R3PB/AIR-TRANSPONDER/Transmitter_AIR/README.md

# Oregon_NR

Данная библиотека Ардуино сделана на основе беспроводного протокола Oregon Scientific v2.1 и v3.0.
 
Последнее обновление 17.03.2021

Формат датчиков AAA Transmitter_AIR V1.2.

Кодирование GPS даннных и передача по радиоканалу на базовую станцию.
 
Так же поддерживается формат следующих датчиков(пока не исключены из поддержки)
// Приём и передача:
// THGN132N (THGR122N, THGN123N),
// RTGN318,
// THGR810.
// Тольок приём:
// THN132N,
// WGR800,	
// UVN800.
//
/////////////////////////////////////////////////////////////////////////////////////////////////////////////////////////////////////////////////

Код приёмника протестирован вовремя полётов планеров Бланик L13, на расстоянии от базовой станции 8 км и высотой полёта 1200 метров, 
при излучаемой мощности 100 милливатт на частоне 144.810 MHz
Для успешного приёма базовой станцией сигнала необходимо соблюдать следующие условия при передаче данных:
Приёмник FM
