R3PB/AIR-TRANSPONDER/Transmitter_AIR/PCB_files/README.MD

Здесь ссылка на разведённые печатные платы и схемы проекта. 
Там же в онлайнредакторе EasyEDA можно отредактировать, или свою улучшенную версию печатных плат.

Project homepage link：	https://oshwlab.com/tech_1596/AIR_TRANSPONDER
Open in editor：		https://easyeda.com/editor#id=67db5b2ea465465c9ad280e50d758a9a
