R3PB/AIR-TRANSPONDER/Transmitter_AIR/img/WhatsApp Image 2021-02-12 at 22.47.51 (3).jpeg

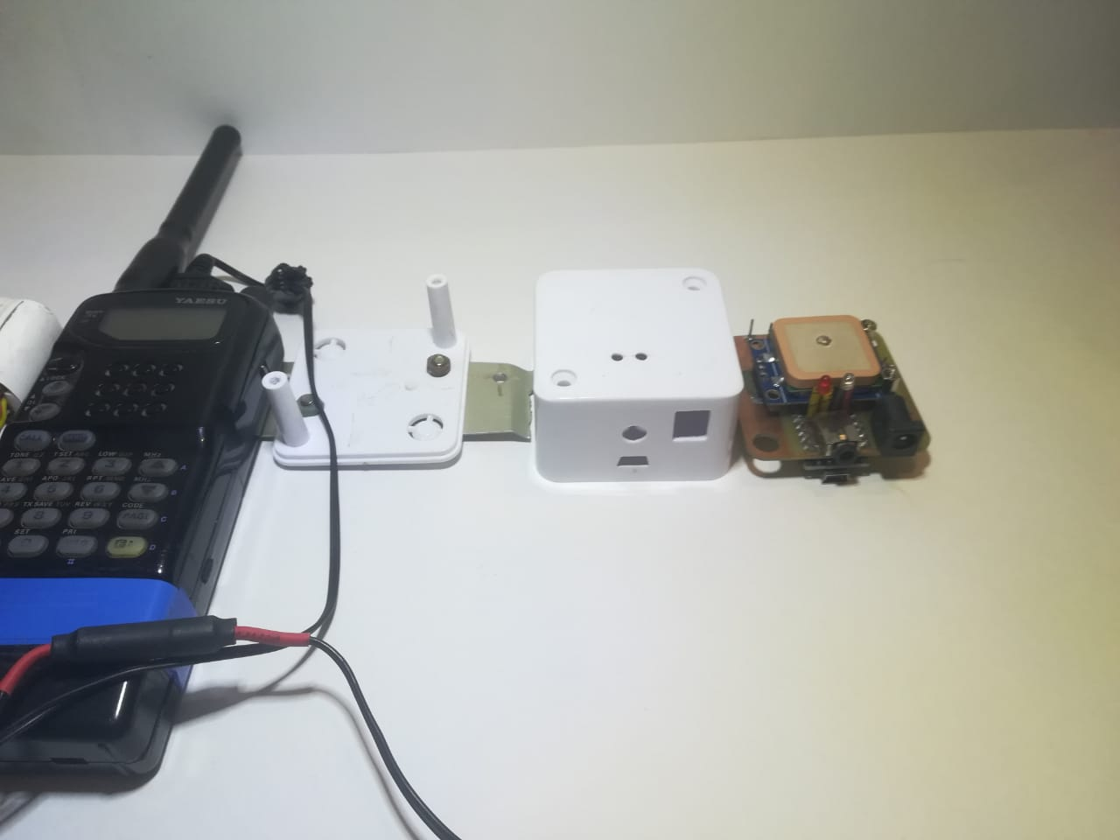
Transmitter_AIR/img/WhatsApp Image 2021-02-12 at 22.47.51 (3).jpeg
