R3PB/AIR-TRANSPONDER/Transmitter_AIR/img/WhatsApp Image 2021-02-12 at 22.47.52 (1).jpeg

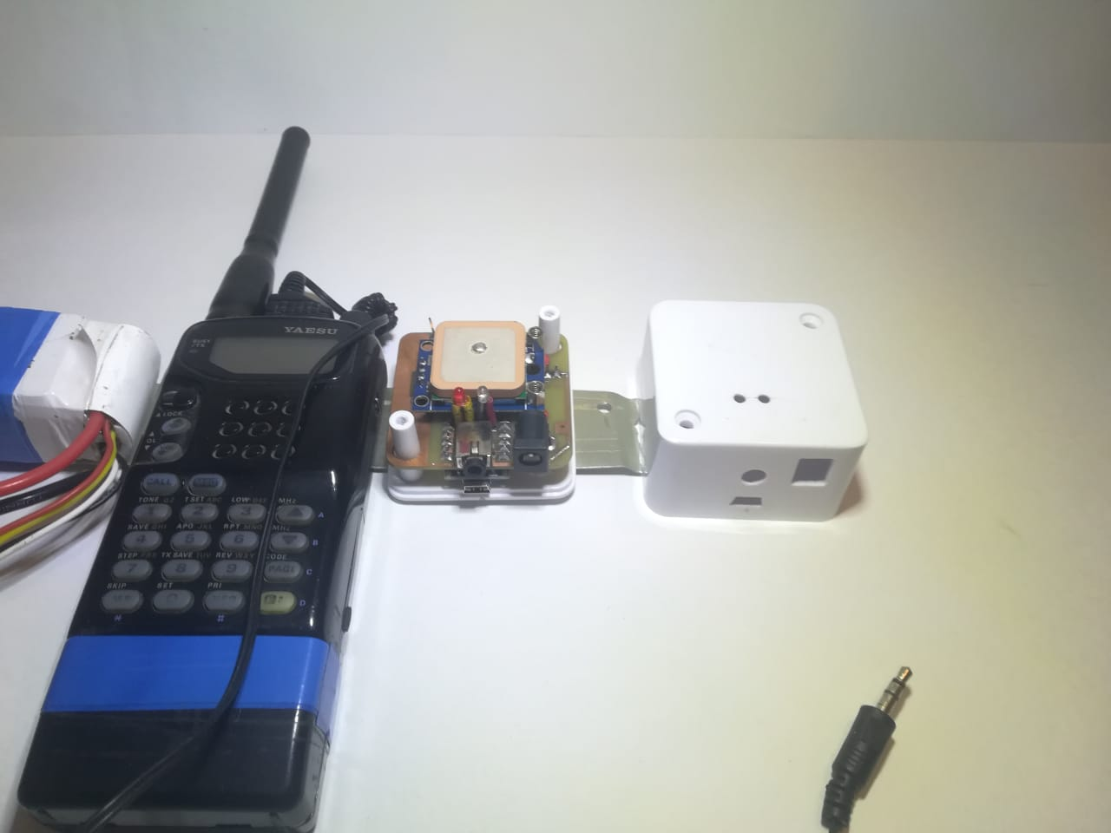
Transmitter_AIR/img/WhatsApp Image 2021-02-12 at 22.47.52 (1).jpeg
