R3PB/AIR-TRANSPONDER/Transmitter_AIR/PCB_files/PCB_pcb v1_2021-02-13(3).pdf

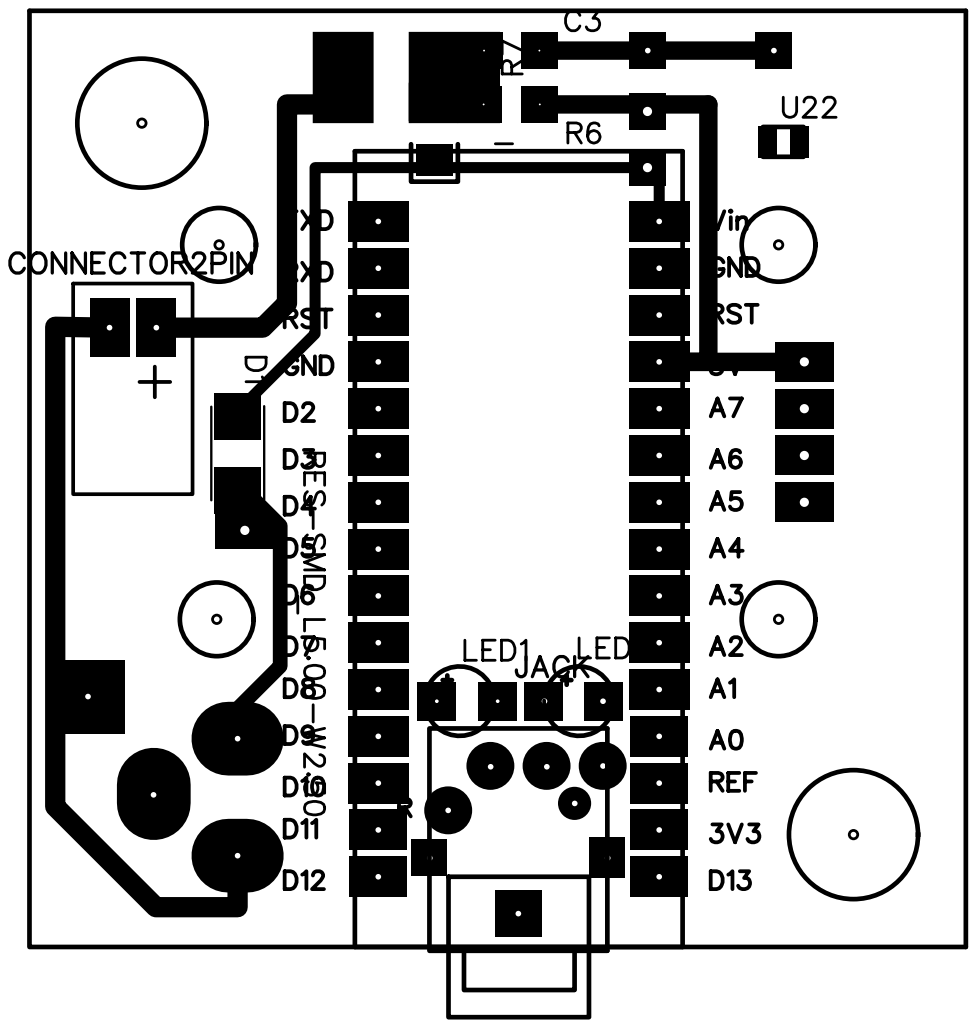
[picture p21: page 1]
