R3PB/AIR-TRANSPONDER/Transmitter_AIR/PCB_files/PCB_pcb v1_2021-02-13(4).pdf

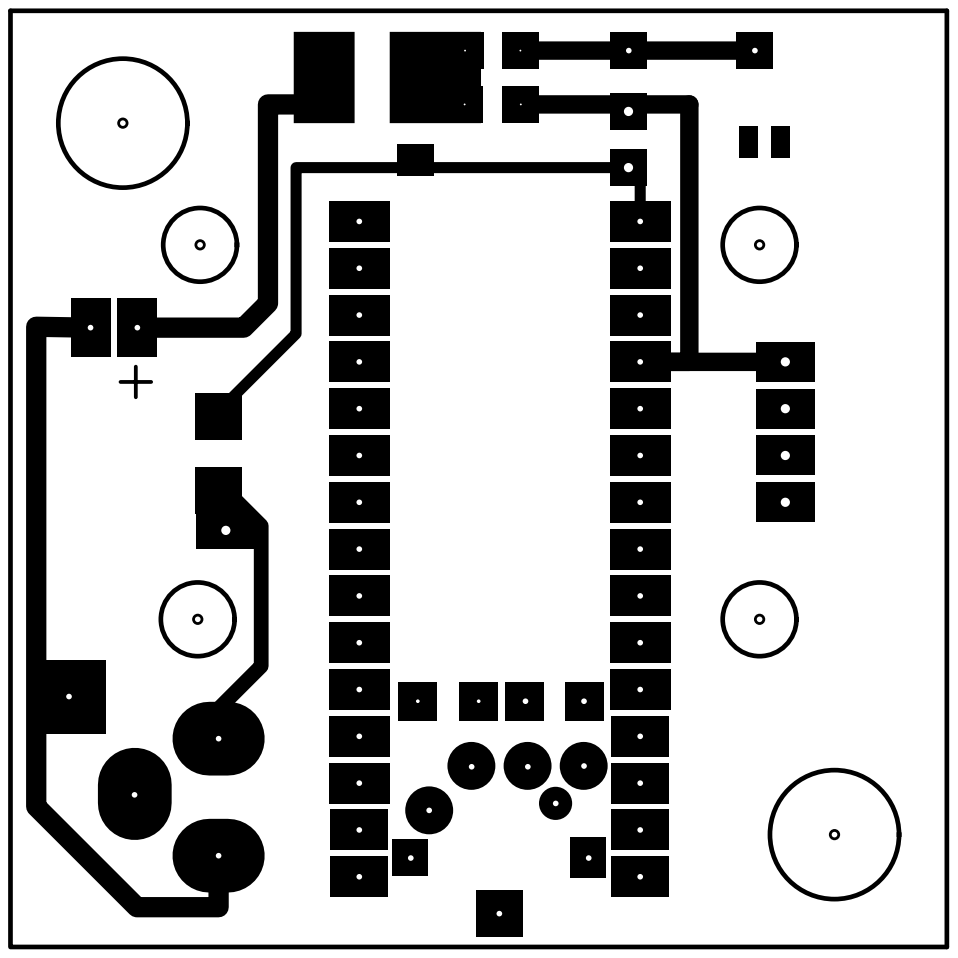
[picture p22: page 1]
