R3PB/AIR-TRANSPONDER/Transmitter_AIR/PCB_files/PCB_pcb v1_2021-02-13(5).pdf

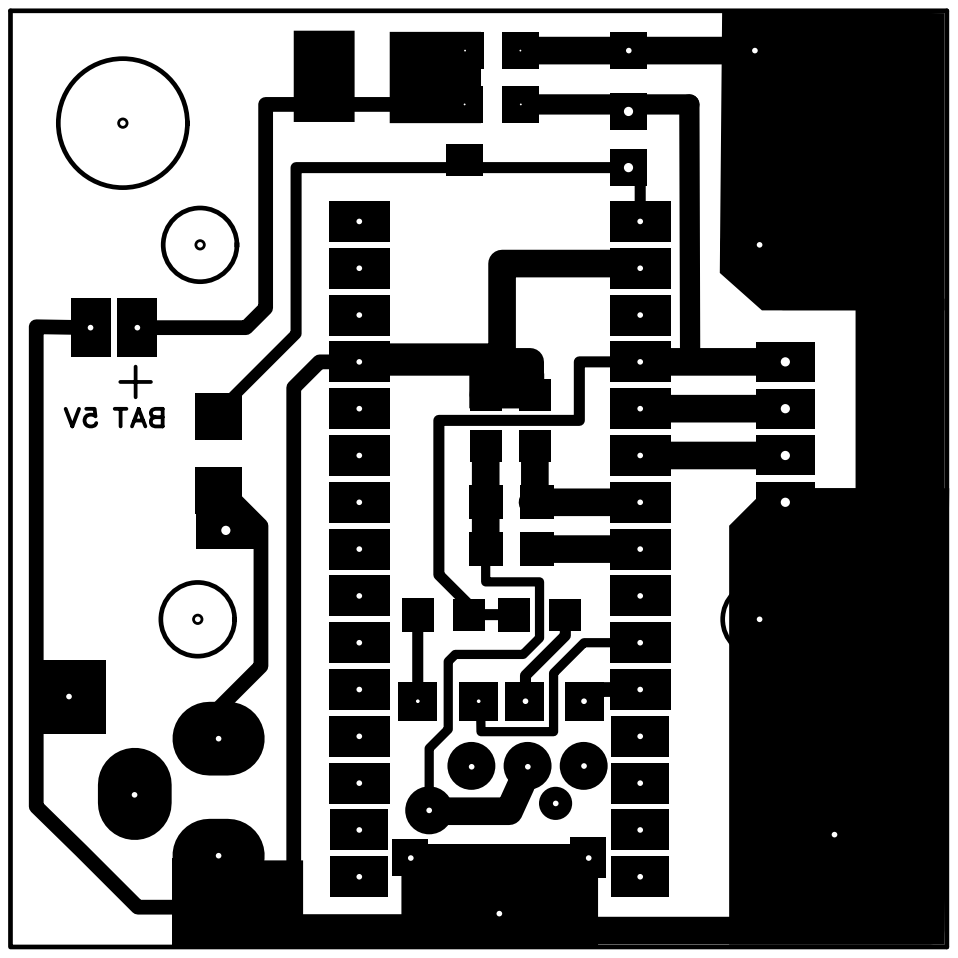
[picture p23: page 1]
