R3PB/AIR-TRANSPONDER/(list of files, drawings)

Other design files:
Transmitter_AIR/PCB_files/pcb v1_2021-02-13.json
