R3PB/AIR-TRANSPONDER/(commit log)

2021-02-12 Скетч транспондера. Передающая часть.
    Кодировани данных GPS. Формирование низкочастотного сигнала, подаваемого на вход трансмиттера.
2021-02-12 Библиотека трансмиттера
2021-02-12 Библиотека модуля GPS NEO-6M-0-001
    Моя версия библиотеки, с незначительными изменениями. 100% рабочая.
2021-02-12 img файлы транспондера
2021-02-12 PCB files
    PCB файлы и ссылки на проект в EasyEDA
    [pcb v1_2021-02-13.json]
2021-02-12 Добавлены библиотеки приёмника(декодера) базы
2021-02-12 Скетч приёмника(декодера) ESP8266. WIFI версия
    Скетч приёмника(декодера) ESP8266. WIFI версия.
2021-02-12 Скетч приёмника(декодера) Arduino UNO. ETH версия.
    Скетч приёмника(декодера) Arduino UNO. Eth версия.
2021-02-12 Осцилоскоп для отладки пакетов.
2021-02-12 Скетчи метеостанции WGR800, BME280
    Для отображения погодных данных на карте, нужны метеодатчики WGR800, BME280. Скетчи для них здесь.
2021-02-14 Описание, принцип работы, история проекта...
2021-02-19 Описание проекта, принцип работы...
2021-02-21 update repo
    [pcb v1_2021-02-13.json]
2021-03-16 modified timeslot and GPS status LED
